KuraZuzu/fast_respect/fast_respect_ピンアサイン.png

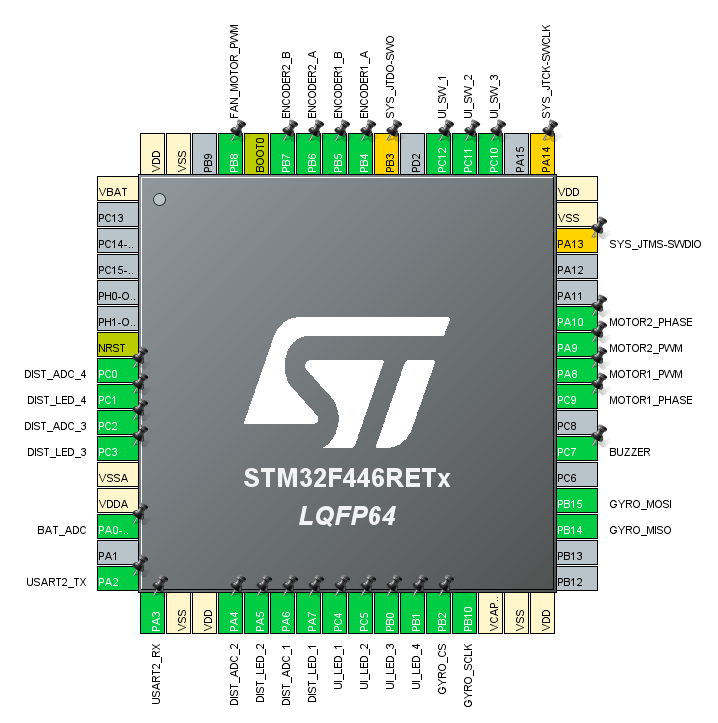
fast_respect_ピンアサイン.png
