KuraZuzu/fast_respect/fast_respect_ピンアサイン_取り付け角度画像.png

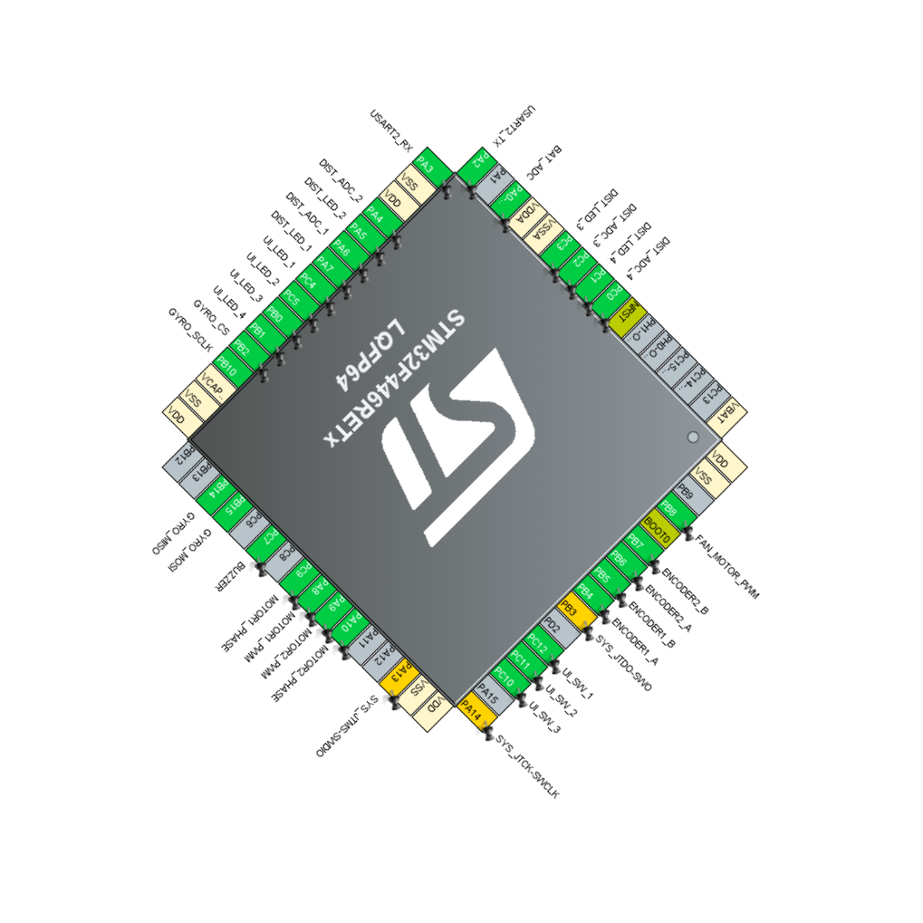
fast_respect_ピンアサイン_取り付け角度画像.png
