KuraZuzu/fast_respect/fast_respect_chassis_R12DXF.dxf

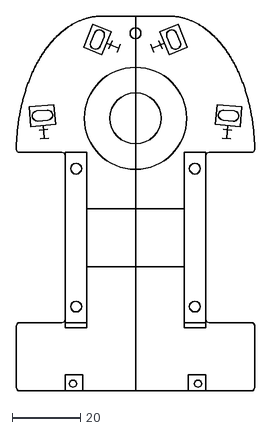
[picture p3: CAD file, 2023-11-23]
fast_respect_chassis_R12DXF.dxf
70.0 x 110.0
