KuraZuzu/fast_respect/fast_respect.kicad_pcb

## KiCad design fast_respect.kicad_pcb (2023-12-19)

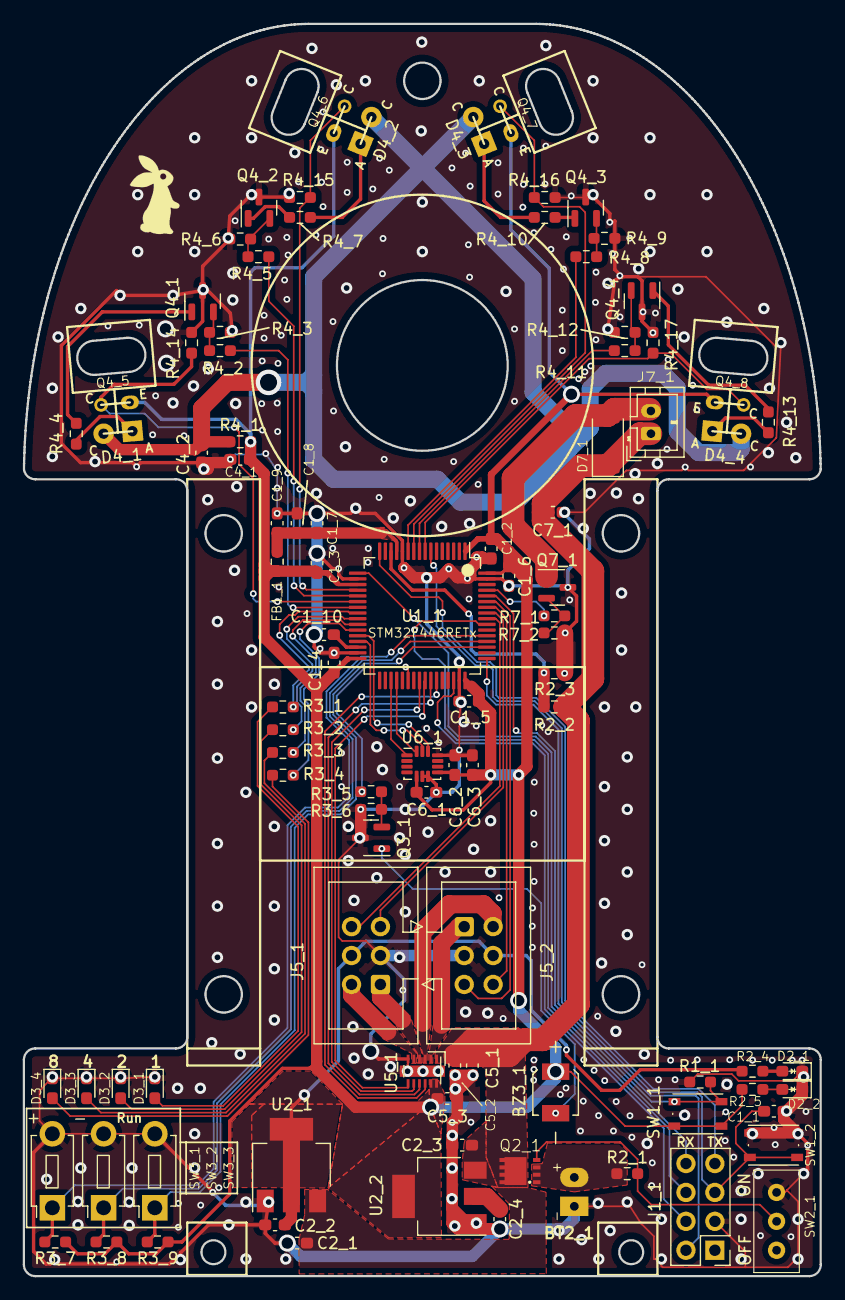
[picture p11: board fast_respect.kicad_pcb from above]

Board: 2 copper layers, 70.0 x 110.0 mm, 97 parts (0 on the bottom side), 72 nets.

Parts:
BT2_1: Battery; 2sBattery
BZ3_1: SMT-0440-T-HT-R; XDCR_SMT-0440-T-HT-R
C1_1, C1_3, C1_4, C1_5, C1_6, C1_8, C5_2, C5_3, C6_2: 0.1uF; C_0603_1608Metric_Pad1.08x0.95mm_HandSolder
C1_2, C1_10: 4.7uF; C_0603_1608Metric_Pad1.08x0.95mm_HandSolder
C1_7, C6_1: 0.01uF; C_0603_1608Metric_Pad1.08x0.95mm_HandSolder
C1_9, C4_1, C4_2: 1uF; C_0603_1608Metric_Pad1.08x0.95mm_HandSolder
C2_1, C2_3, C5_1, C7_1: 10uF; C_0603_1608Metric_Pad1.08x0.95mm_HandSolder
C2_2, C2_4: 22uF; C_0603_1608Metric_Pad1.08x0.95mm_HandSolder
C6_3: 2.2uF; C_0603_1608Metric_Pad1.08x0.95mm_HandSolder
D2_1: LED_R; LED_0603_1608Metric_Pad1.05x0.95mm_HandSolder
D2_2: LED_Y; LED_0603_1608Metric_Pad1.05x0.95mm_HandSolder
D3_1: LED_B1; LED_0603_1608Metric_Pad1.05x0.95mm_HandSolder
D3_2: LED_B2; LED_0603_1608Metric_Pad1.05x0.95mm_HandSolder
D3_3: LED_B3; LED_0603_1608Metric_Pad1.05x0.95mm_HandSolder
D3_4: LED_B4; LED_0603_1608Metric_Pad1.05x0.95mm_HandSolder
D4_1, D4_2, D4_3, D4_4: SFH4550; DIstance-Sensor_LED_D5.0mm
D7_1: RB080LAM-30TR; D_SOD-128
FB1_1: FerriteBead; R_0603_1608Metric
J1_1: Conn_02x04_Odd_Even; PinHeader_2x04_P2.54mm_Vertical
J5_1, J5_2: Conn_02x03_Odd_Even; IDC-Header_2x03_P2.54mm_Vertical
J7_1: Conn_01x02; JST_PH_B2B-PH-K_1x02_P2.00mm_Vertical
Q2_1: AONM7421; AON7421
Q3_1, Q4_1, Q4_2, Q4_3, Q4_4, Q7_1: IRLML6344T; SOT-23
Q4_5, Q4_6, Q4_7, Q4_8: ST-1KL3A; DIstance-Sensor_PHTR_D5.0mm
R1_1, R3_6, R4_3, R4_6, R4_9, R4_12, R7_2: 10k; R_0603_1608Metric_Pad0.98x0.95mm_HandSolder
R2_1: 100k; R_0603_1608Metric_Pad0.98x0.95mm_HandSolder
R2_2: 2k; R_0603_1608Metric_Pad0.98x0.95mm_HandSolder
R2_3, R3_7, R3_8, R3_9, R4_14, R4_15, R4_16, R4_17: 1k; R_0603_1608Metric_Pad0.98x0.95mm_HandSolder
R2_4: 620; R_0603_1608Metric_Pad0.98x0.95mm_HandSolder
R2_5: 280; R_0603_1608Metric_Pad0.98x0.95mm_HandSolder
R3_1, R3_2, R3_3, R3_4: 100; R_0603_1608Metric_Pad0.98x0.95mm_HandSolder
R3_5, R4_2, R4_5, R4_8, R4_11, R7_1: 10; R_0603_1608Metric_Pad0.98x0.95mm_HandSolder
R4_1: 20; R_0603_1608Metric_Pad0.98x0.95mm_HandSolder
R4_4, R4_7, R4_10, R4_13: 1; R_0603_1608Metric_Pad0.98x0.95mm_HandSolder
SW1_1: BOOT0_SW; SW_Push_1P1T_NO_Vertical_Wuerth_434133025816
SW1_2: NRST_SW; SW_Push_1P1T_NO_Vertical_Wuerth_434133025816
SW2_1: SW_SPDT; SW_Slide_SS12D01G4_AKIZUKI
SW3_1, SW3_2, SW3_3: SW_Push; SW_PUSH_1P1T_6x3.5mm_H4.3_APEM_MJTP1243
U1_1: STM32F446RETx; LQFP-64_10x10mm_P0.5mm
U2_1: AZ1117-5.0; SOT-223-3_TabPin2
U2_2: AZ1117-3.3; SOT-223-3_TabPin2
U5_1: DRV8835DSSR; DRV8835_ThermalExpanded_WSON-12-1EP
U6_1: ICM-42688-P; LGA-14_ExpandPad_3x2.5mm_P0.5mm_LayoutBorder3x4y

Connections:
+3.3V: BZ3_1.LOAD+, C1_2.2, C1_3.2, C1_4.2, C1_5.2, C1_6.2, C2_4.1, C4_1.1, C5_3.2, C6_1.1, C6_2.1, C6_3.1, FB1_1.2, Q4_5.1 (C), Q4_6.1 (C), Q4_7.1 (C), Q4_8.1 (C), R2_5.1, R3_7.1, R3_8.1, R3_9.1, R4_1.2, SW1_1.1, U1_1.1 (VBAT), U1_1.19 (VDD), U1_1.32 (VDD), U1_1.48 (VDD), U1_1.64 (VDD), U2_2.2 (VO), U5_1.11 (Mode), U5_1.12 (VCC), U6_1.5 (VDDIO), U6_1.8 (VDD)
+5V: C2_2.1, J5_1.4, J5_2.4, R2_4.1, U2_1.2 (VO)
+8V: C2_1.1, C2_3.1, C5_1.2, C5_2.1, C7_1.1, D7_1.1 (K), J7_1.1, Q2_1.3 (D), R2_2.1, U2_1.3 (VI), U2_2.3 (VI), U5_1.1 (VM)
BAT_ADC: R2_2.2, R2_3.1, U1_1.14 (PA0)
BOOT0: R1_1.1, SW1_1.2, U1_1.60 (BOOT0)
BUZZER_PWM: R3_5.1, U1_1.38 (PC7)
DIST_ADC_1: Q4_5.2 (E), R4_14.1, U1_1.22 (PA6)
DIST_ADC_2: Q4_6.2 (E), R4_15.1, U1_1.20 (PA4)
DIST_ADC_3: Q4_7.2 (E), R4_16.1, U1_1.10 (PC2)
DIST_ADC_4: Q4_8.2 (E), R4_17.1, U1_1.8 (PC0)
DIST_LED_1: R4_2.1, U1_1.23 (PA7)
DIST_LED_2: R4_5.1, U1_1.21 (PA5)
DIST_LED_3: R4_8.1, U1_1.11 (PC3)
DIST_LED_4: R4_11.1, U1_1.9 (PC1)
ENCODER1_A: J5_1.6, U1_1.56 (PB4)
ENCODER1_B: J5_1.5, U1_1.57 (PB5)
ENCODER2_A: J5_2.6, U1_1.58 (PB6)
ENCODER2_B: J5_2.5, U1_1.59 (PB7)
FAN_MOTOR_PWM: R7_1.1, U1_1.61 (PB8)
GND: BT2_1.2 (-), C1_1.2, C1_2.1, C1_3.1, C1_4.1, C1_5.1, C1_6.1, C1_7.1, C1_8.1, C1_9.1, C1_10.2, C2_1.2, C2_2.2, C2_3.2, C2_4.2, C4_1.2, C4_2.2, C5_1.1, C5_2.2, C5_3.1, C6_1.2, C6_2.2, C6_3.2, C7_1.2, D2_1.1 (K), D2_2.1 (K), D3_1.1 (K), D3_2.1 (K), D3_3.1 (K), D3_4.1 (K), J1_1.3, J5_1.3, J5_2.3, Q3_1.3 (S), Q4_1.3 (S), Q4_2.3 (S), Q4_3.3 (S), Q4_4.3 (S), Q7_1.3 (S), R1_1.2, R2_3.2, R3_6.2, R4_3.2, R4_6.2, R4_9.2, R4_12.2, R4_14.2, R4_15.2, R4_16.2, R4_17.2, R7_2.2, SW1_2.2, SW2_1.1 (A), SW3_1.2, SW3_2.2, SW3_3.2, U1_1.12 (VSSA), U1_1.18 (VSS), U1_1.31 (VSS), U1_1.47 (VSS), U1_1.63 (VSS), U2_1.1 (GND), U2_2.1 (GND), U5_1.6 (GND), U6_1.6 (GND), U6_1.7 (RESV), U6_1.11 (RESV)
GYRO_CS: U1_1.28 (PB2), U6_1.12 (AP_CS)
GYRO_MISO: U1_1.35 (PB14), U6_1.1 (AP_SDO/AP_AD0)
GYRO_MOSI: U1_1.36 (PB15), U6_1.14 (AP_SDA/AP_SDIO/AP_SDI)
GYRO_SCLK: U1_1.29 (PB10), U6_1.13 (AP_SCL/AP_SCLK)
MOTOR1_OUT_1: J5_1.1, U5_1.4 (BOUT1)
MOTOR1_OUT_2: J5_1.2, U5_1.5 (BOUT2)
MOTOR1_PHASE: U1_1.40 (PC9), U5_1.8 (BIN1/B_PHASE)
MOTOR1_PWM: U1_1.41 (PA8), U5_1.7 (BIN2/B_ENABLE)
MOTOR2_OUT_1: J5_2.1, U5_1.2 (AOUT1)
MOTOR2_OUT_2: J5_2.2, U5_1.3 (AOUT2)
MOTOR2_PHASE: U1_1.43 (PA10), U5_1.10 (AIN1/A_PHASE)
MOTOR2_PWM: U1_1.42 (PA9), U5_1.9 (AIN2/A_ENABLE)
NRST: C1_1.1, J1_1.5, SW1_2.1, U1_1.7 (NRST)
unnamed: BT2_1.1 (+), Q2_1.2 (S), R2_1.1
unnamed: D2_1.2 (A), R2_4.2
unnamed: D2_2.2 (A), R2_5.2
unnamed: D3_1.2 (A), R3_1.2
unnamed: D3_2.2 (A), R3_2.2
unnamed: D3_3.2 (A), R3_3.2
unnamed: D3_4.2 (A), R3_4.2
unnamed: C4_2.1, D4_1.2 (A), D4_2.2 (A), D4_3.2 (A), D4_4.2 (A), R4_1.1
unnamed: D4_1.1 (K), R4_4.1
unnamed: D4_2.1 (K), R4_7.1
unnamed: D4_3.1 (K), R4_10.1
unnamed: D4_4.1 (K), R4_13.1
unnamed: D7_1.2 (A), J7_1.2, Q7_1.1 (D)
unnamed: Q2_1.1 (G), R2_1.2, SW2_1.2 (B)
unnamed: BZ3_1.LOAD-, Q3_1.1 (D)
unnamed: Q3_1.2 (G), R3_5.2, R3_6.1
unnamed: Q4_1.1 (D), R4_4.2
unnamed: Q4_1.2 (G), R4_2.2, R4_3.1
unnamed: Q4_2.1 (D), R4_7.2
unnamed: Q4_2.2 (G), R4_5.2, R4_6.1
unnamed: Q4_3.1 (D), R4_10.2
unnamed: Q4_3.2 (G), R4_8.2, R4_9.1
unnamed: Q4_4.1 (D), R4_13.2
unnamed: Q4_4.2 (G), R4_11.2, R4_12.1
unnamed: Q7_1.2 (G), R7_1.2, R7_2.1
unnamed: C1_10.1, U1_1.30 (VCAP_1)
unnamed: C1_7.2, C1_8.2, C1_9.2, FB1_1.1, U1_1.13 (VDDA)
RX: J1_1.8, U1_1.17 (PA3)
SWCLK: J1_1.2, U1_1.49 (PA14)
SWDIO: J1_1.4, U1_1.46 (PA13)
SWO: J1_1.6, U1_1.55 (PB3)
TX: J1_1.7, U1_1.16 (PA2)
UI_LED_1: R3_1.1, U1_1.24 (PC4)
UI_LED_2: R3_2.1, U1_1.25 (PC5)
UI_LED_3: R3_3.1, U1_1.26 (PB0)
UI_LED_4: R3_4.1, U1_1.27 (PB1)
UI_SW_1: R3_7.2, SW3_1.1, U1_1.53 (PC12)
UI_SW_2: R3_8.2, SW3_2.1, U1_1.52 (PC11)
UI_SW_3: R3_9.2, SW3_3.1, U1_1.51 (PC10)
