KuraZuzu/fast_respect/(commit log)

2023-08-23 回路図プロトタイプ作成
    [distance_sensor.kicad_sch, fast_respect.kicad_pcb, fast_respect.kicad_sch, gyro_sensor.kicad_sch, motor.kicad_sch, motor_and_encoder.kicad_sch, power.kicad_sch, user_interface.kicad_sch]
2023-08-23 コンデンサの表記を統一
    [distance_sensor.kicad_sch, gyro_sensor.kicad_sch, motor_and_encoder.kicad_sch]
2023-08-23 UIのブザー型番を追記
    [motor_and_encoder.kicad_sch, user_interface.kicad_sch]
2023-08-28 モータドライバの型番追加名称変更
    [motor_and_encoder.kicad_sch]
2023-08-28 VCAP1のコンデンサの値追加
    [fast_respect.kicad_sch]
2023-08-28 距離センサのLED制限抵抗のミスを修正。アノテーションも振り直した。
    [distance_sensor.kicad_sch]
2023-08-28 電源スイッチ用の回路のPchMOSFETの向き修正
    [power.kicad_sch]
2023-08-28 エンコーダに型番表記追加
    [motor_and_encoder.kicad_sch]
2023-08-28 ジャイロセンサのアノテーションがモータドライバと重複していたので修正
    [gyro_sensor.kicad_sch]
2023-08-28 pdfに回路図を生成した
2023-08-29 モータドライバのVMに対して10uFのコンデンサ追加（10uFの値は秋月のモジュールを参考）
    [motor_and_encoder.kicad_sch]
2023-08-29 距離センサに強すぎる電流を抑える制限抵抗追加
    [distance_sensor.kicad_sch]
2023-08-29 距離センサの制限抵抗をsource側からdrain側に変更
    [distance_sensor.kicad_sch]
2023-08-29 分圧の抵抗値が間違っていたので修正
    [motor_and_encoder.kicad_sch, power.kicad_sch]
2023-08-30 アノテーション番号ミスの修正とフットプリント割り当て途中（部品リストも途中生成）
    [distance_sensor.kicad_sch, fast_respect.csv, fast_respect.kicad_sch, gyro_sensor.kicad_sch, motor_and_encoder.kicad_sch, power.kicad_sch, user_interface.kicad_sch]
2023-09-01 フェライトビーズに型番追加し、自作パッケージの構成へこう
    [distance_sensor.kicad_sch, fast_respect.kicad_sch, motor_and_encoder.kicad_sch, power.kicad_sch, user_interface.kicad_sch]
2023-09-01 自作パッケージのフォルダ名変更
2023-09-01 ジャイロとモータドライバのフットプリント作成して登録、シンボルと紐付けた。
    [gyro_sensor.kicad_sch, motor_and_encoder.kicad_sch]
2023-09-04 ブザーSMT-0440のフットプリントとシンボルをインポートして、回路図のシンボルを変更した。
    [motor_and_encoder.kicad_sch, user_interface.kicad_sch]
2023-09-04 スイッチ以外のフットプリント割当完了
    [fast_respect.kicad_sch, motor_and_encoder.kicad_sch, power.kicad_sch, user_interface.kicad_sch]
2023-09-04 秋月電子のスライドスイッチのフットプリントを追加して全てのフットプリント割当も完了
    [fast_respect.kicad_sch, power.kicad_sch, user_interface.kicad_sch]
2023-09-07 部品リストをcsvに出力して購入先等の情報を付加した（付加データはまだ途中）
    [fast_respect.csv]
2023-09-08 部品リストのcsv完成
    [fast_respect.csv]
2023-09-08 部品リストの間違いを修正
    [fast_respect.csv]
2023-10-10 吸引ファンのシートとピン追加
    [fast_respect.kicad_sch, motor_and_encoder.kicad_sch, suction_fan.kicad_sch]
2023-10-10 吸引ファンモータのコネクタを追加
    [suction_fan.kicad_sch]
2023-10-23 吸引モータ周りの回路修正
    [fast_respect.kicad_sch, motor_and_encoder.kicad_sch, suction_fan.kicad_sch]
2023-11-23 吸引ファンのダイオードの規格やフットプリント割当を完了（完成）
    [motor_and_encoder.kicad_sch, suction_fan.kicad_sch]
2023-11-23 ネットリスト出力
2023-11-23 R12形式の基板概形DXFデータをファイルに入れた
    [fast_respect_chassis_R12DXF.dxf]
2023-11-23 基板概形インポートしてシルク印刷線とカット線分けた
    [fast_respect.kicad_pcb]
2023-11-23 センサのフットプリント配置
    [fast_respect.kicad_pcb]
2023-11-23 重要パーツ諸々配置した（スイッチの形状や名前とか変えたほうがいいかも）
    [fast_respect.kicad_pcb]
2023-11-23 色々配置した。これから新たなスイッチのフットプリント作る
    [fast_respect.kicad_pcb]
2023-11-23 押しボタンスイッチのフットプリント割り当てを変更
    [fast_respect.kicad_sch, motor_and_encoder.kicad_sch, user_interface.kicad_sch]
2023-11-23 一部のスイッチの名称変更
    [fast_respect.kicad_sch]
2023-11-23 ネットリスト更新
2023-11-23 ネットリストを基板に反映
    [fast_respect.kicad_pcb]
2023-11-23 抵抗とか以外のコア部品配置（バッテリの端子だけ変えた方が良さそう）
    [fast_respect.kicad_pcb]
2023-11-23 モータ+エンコーダのボックス端子の位置がナットと干渉するので修正
    [fast_respect.kicad_pcb]
2023-11-24 ジャイロセンサを中央に配置
    [fast_respect.kicad_pcb]
2023-11-25 2sBatteryのフットプリント作成
2023-11-25 バッテリ端子のフットプリントを割り当ててネットリストに出力して取り込み
    [power.kicad_sch]
2023-11-25 レギュレータ２つのフットプリント割り当てを2ピンが２つあるものに変更した
    [fast_respect.kicad_pcb, motor_and_encoder.kicad_sch, power.kicad_sch]
2023-11-25 gitignoreにKiCAD編集中のファイルを反映した
    [fast_respect.kicad_pcb]
2023-11-25 グリッド原点のをグローバル座標の原点に戻した
    [fast_respect.kicad_pcb]
2023-11-26 マイコンの向きを整えた
    [fast_respect.kicad_pcb]
2023-11-26 UIスイッチ３種類をマイコンピンに割り当て忘れてたので割り当てた
    [fast_respect.kicad_sch, motor_and_encoder.kicad_sch, user_interface.kicad_sch]
2023-11-26 UIスイッチのピン割り当てをネットリストに反映
    [fast_respect.kicad_pcb]
2023-11-26 DRV8835のシンボルのピン割当ミスを修正してシンボル回路図修正(6->8)
    [motor_and_encoder.kicad_sch]
2023-11-26 DRV8835のピン割当ミスを反映
    [fast_respect.kicad_pcb]
2023-11-26 DRV8835用にフットプリント作ってシンボルと紐付けた（シンボルも少し更新）
    [motor_and_encoder.kicad_sch]
2023-11-26 DRV8835のフットプリントをネットリストに反映させてPCBも更新した
    [fast_respect.kicad_pcb]
2023-11-26 距離センサのPCB位置を考慮してピン割り当てを変更した（1,2,3,4 -> 4,3,2,1）
    [fast_respect.kicad_pcb, fast_respect.kicad_sch]
2023-11-26 マイコンの位置を再調整
    [fast_respect.kicad_pcb]
2023-11-26 マイコンのピンアサイン画像を更新
2023-11-26 回路図のPDFを更新
2023-11-26 取り付け角度の画像作成
2023-11-26 ピンアサイン画像のミス修正
2023-11-26 UIのスイッチやLED、書き込み側や電源スイッチの配置を修正
    [fast_respect.kicad_pcb]
2023-11-27 1、２番台の簡易配置をした
    [fast_respect.kicad_pcb]
2023-11-27 全体に全体に おおまかな部品配置完了
    [fast_respect.kicad_pcb]
2023-11-27 色々再配置
    [fast_respect.kicad_pcb]
2023-11-27 吸引ファンの端子がタイヤのナットや吸引ファンマウンタに干渉しそうなので位置修正
    [fast_respect.kicad_pcb]
2023-11-27 各配置を決定した。あとは細かい移動や回転のみ
    [fast_respect.kicad_pcb]
2023-11-27 全ての詳細な位置の数値を決定
    [fast_respect.kicad_pcb]
2023-11-27 吸引ファンマウンタと吸引ファンケーブルが鑑賞する恐れを考慮して移動
    [fast_respect.kicad_pcb]
2023-11-27 全ての配置と方向を設定した。あとは配線するだけ（ブランチを切って作業）
    [fast_respect.kicad_pcb]
2023-11-27 デザインルールの制約を記述
    [fast_respect.kicad_pcb]
2023-11-28 ネットリストを定義（まだ割り振りしていない）
2023-11-28 モータボックス位置再修正
    [fast_respect.kicad_pcb]
2023-11-28 配線とビアのサイズ郡を定義した
2023-11-28 更に配線幅追加
2023-11-28 ジャイロとモータドライバの信号線を書いた
    [fast_respect.kicad_pcb]
2023-11-28 距離センサの信号線まで引いた
    [fast_respect.kicad_pcb]
2023-11-28 ブザー位置をずらして距離センサのLEDのコンデンサ経由の配線を太くした
    [fast_respect.kicad_pcb]
2023-11-28 3.3Vのラインまで距離センサをつないだ
    [fast_respect.kicad_pcb]
2023-11-29 距離センサをGND含めて結んだ
    [fast_respect.kicad_pcb]
2023-11-29 電源周りを配線勧めた
    [fast_respect.kicad_pcb]
2023-11-29 モータドライバからのモータ出力配線を引いた
    [fast_respect.kicad_pcb]
2023-11-29 電源周りを引いた。モータドライバや抵抗、コンデンサの場所を逐次変更した
    [fast_respect.kicad_pcb]
2023-11-29 色々配線
    [fast_respect.kicad_pcb]
2023-11-29 3.3V駆動の配線を整えた
    [fast_respect.kicad_pcb]
2023-11-29 センサとブザー周りの電源修正
    [fast_respect.kicad_pcb]
2023-11-29 UIスイッチ以外配線
    [fast_respect.kicad_pcb]
2023-11-29 UI_LED以外を引いた
    [fast_respect.kicad_pcb]
2023-11-29 全て配線完了（このコミットではUI_LEDを配線）
    [fast_respect.kicad_pcb]
2023-11-29 DRCエラーを解消（まだ未配線あった）
    [fast_respect.kicad_pcb]
2023-11-29 配線完了（DRCもシルクとか以外完了） [補足]距離センサのLEDとフォトトラの冗長な電源配線はノイズのるかもしれないから消していいかも。
    [fast_respect.kicad_pcb]
2023-11-30 数値表示とかを整えた
    [fast_respect.kicad_pcb]
2023-11-30 一旦距離センサのLEDとフォトトランジスタの電源汚すぎるので削除
    [fast_respect.kicad_pcb]
2023-11-30 配線し直し。主に距離線センサ関連の電源周り。まだやっていないがベタGNDもだいぶやりやすくなったはず
    [fast_respect.kicad_pcb]
2023-11-30 ビアの径を変更始め
    [fast_respect.kicad_pcb]
2023-12-01 印刷面以外は納得の配線した（配線太さやビアも納得してるがモータドライバ出力の0.25区間を短くしたい
    [fast_respect.kicad_pcb]
2023-12-01 更にビアを追加した。基板左下と右側の外周がベタグランド通じてないので不安が残る
    [fast_respect.kicad_pcb]
2023-12-03 ベタグランドのために8Vとか吸引ファン関連の素子の位置変えた
    [fast_respect.kicad_pcb]
2023-12-03 ベタグランドのために電源周り位置変えた
    [fast_respect.kicad_pcb]
2023-12-04 電源周りを変えて更にベタに強くした
    [fast_respect.kicad_pcb]
2023-12-04 UIスイッチ周りを整えてベタ強化
    [fast_respect.kicad_pcb]
2023-12-04 配線を完全に完了した。ベタグランドのビアはこれから打つ
    [fast_respect.kicad_pcb]
2023-12-04 ビア打つところまで完全に完了したと思う
    [fast_respect.kicad_pcb]
2023-12-04 ビア打ち直した。これから浮島とかノイズ原因に鳴る半島を削除したい。
    [fast_respect.kicad_pcb]
2023-12-04 ビアを１つ新たに打った。とりあえずシルクとかのエラーを消したい。
    [fast_respect.kicad_pcb]
2023-12-04 色々と文字とかのプリント関係を直したが、これ以上は無視設定が必要そう（Fabの値とシルクがかぶる）
    [fast_respect.kicad_pcb]
2023-12-04 これ以上の印刷面の整えは無理だと思う
    [fast_respect.kicad_pcb]
2023-12-04 マイコンのピンの印刷情報変更
    [fast_respect.kicad_pcb]
2023-12-04 UI_LEDの印刷面の数値を変えた
    [fast_respect.kicad_pcb]
2023-12-04 8Vラインを少し緩やかにした
    [fast_respect.kicad_pcb]
2023-12-04 ウラ面に機体名のシルク追加
    [fast_respect.kicad_pcb]
2023-12-07 ビアと配線を広域削除。表示を値からリファレンスにした
    [fast_respect.kicad_pcb]
2023-12-07 AON7421のフットプリント追加
    [power.kicad_sch, suction_fan.kicad_sch]
2023-12-07 AON7421のシンボル作成
2023-12-07 シンボルとフットプリントのピン番号と割り振りを修正
2023-12-07 AON7421のシンボルを差し替えた
2023-12-07 AON7421のシンボル差し替え
    [power.kicad_sch]
2023-12-07 UI関連のアノテーション番号修正
    [user_interface.kicad_sch]
2023-12-07 バッテリのフットぷりとに領域追加
2023-12-08 ネットリストを更新してpcbに反映
    [fast_respect.kicad_pcb]
2023-12-08 距離センサのLEDとPHTRのフットプリント更新
2023-12-08 距離センサのフットプリントを修正してpcbまで反映
    [distance_sensor.kicad_sch, fast_respect.kicad_pcb]
2023-12-08 各パーツと、その近くのコンデンサの配置完了
    [fast_respect.kicad_pcb]
2023-12-08 これから部品配置を考えつつ配線開始
    [fast_respect.kicad_pcb]
2023-12-08 シンボルのモータの左右を入れ替え
    [fast_respect.kicad_pcb, motor_and_encoder.kicad_sch]
2023-12-08 モータの出力が入れ替わっていなかったので修正
2023-12-08 モータの左右入れ替えをpcbにも反映
    [motor_and_encoder.kicad_sch]
2023-12-08 一旦作業終了
2023-12-10 ２回めのだいたい部品配置完了
    [fast_respect.kicad_pcb]
2023-12-10 電源スイッチ周りを整えた
    [fast_respect.kicad_pcb]
2023-12-10 モータアウトプットのラインと領域を引いた
    [fast_respect.kicad_pcb]
2023-12-10 エンコーダの信号線を引いた
    [fast_respect.kicad_pcb]
2023-12-10 バッテリ+側のベタ追加
    [fast_respect.kicad_pcb]
2023-12-10 8Vラインの大本とか引いた
    [fast_respect.kicad_pcb]
2023-12-10 8V付近の電源周り修正
    [fast_respect.kicad_pcb]
2023-12-11 モータドライバ信号線配線完了
    [fast_respect.kicad_pcb]
2023-12-11 モーター信号線少し修正
    [fast_respect.kicad_pcb]
2023-12-11 マイコンのVDDA周り配線
    [fast_respect.kicad_pcb]
2023-12-11 取り急ぎ電源周り完了
    [fast_respect.kicad_pcb]
2023-12-11 色々配置中
    [fast_respect.kicad_pcb]
2023-12-11 距離センサの向き修正（それと少しの配線追加）
    [fast_respect.kicad_pcb]
2023-12-11 センサ周りの部品を配置
    [fast_respect.kicad_pcb]
2023-12-12 距離センサ周り引いた
    [fast_respect.kicad_pcb]
2023-12-12 左側の3.3vのラインを車体前方まで引いた
    [fast_respect.kicad_pcb]
2023-12-12 電源周りを整えてUIと書き込み配線以外完成
    [fast_respect.kicad_pcb]
2023-12-12 UI_LED接続
    [fast_respect.kicad_pcb]
2023-12-12 書き込みピン配線
    [fast_respect.kicad_pcb]
2023-12-12 UIスイッチ配線完了
    [fast_respect.kicad_pcb]
2023-12-12 全て配線して電気的なDRCは消した
    [fast_respect.kicad_pcb]
2023-12-12 ベタ塗った（ビアない段階だがきれい）
    [fast_respect.kicad_pcb]
2023-12-12 5Vのサーマルパッドベタの領域増やした
    [fast_respect.kicad_pcb]
2023-12-12 モータで使うGNDのビアを大きくした
    [fast_respect.kicad_pcb]
2023-12-12 これからベタGNDのビアを打つ（ついでに一部の配線角度変更）
    [fast_respect.kicad_pcb]
2023-12-12 とりあえずビア打ち完了
    [fast_respect.kicad_pcb]
2023-12-12 ビア打ち直し
    [fast_respect.kicad_pcb]
2023-12-12 ベタGNDをサーマルリリーフにしてビア追加
    [fast_respect.kicad_pcb]
2023-12-12 ビアの配置と島の削除全て完了（印刷面以外は完成）
    [fast_respect.kicad_pcb]
2023-12-13 設計図上に移動して原点セット
    [fast_respect.kicad_pcb]
2023-12-13 印字整え中
    [fast_respect.kicad_pcb]
2023-12-13 印刷面のサイズ位置とか変更
    [fast_respect.kicad_pcb]
2023-12-13 ベタGNDの修正（3.3vと8vを重ねてベタ追加）
    [fast_respect.kicad_pcb]
2023-12-13 吸引ファンのノイズでリセットピンに影響を及ぼす可能性を考慮してある程度戻しつつベタGNDが引けるように微修正
    [fast_respect.kicad_pcb]
2023-12-13 印刷面整えた
    [fast_respect.kicad_pcb]
2023-12-13 マイコンの一部のコンデンサの領域かぶりを修正（これからレビュー出す）
    [fast_respect.kicad_pcb]
2023-12-14 AON7421のフットプリントに裏面シルクが入っていたのを修正
    [fast_respect.kicad_pcb]
2023-12-14 アールティロゴを追加
    [fast_respect.kicad_pcb]
2023-12-14 マシン名とアールティロゴシルク追加
    [fast_respect.kicad_pcb]
2023-12-14 5VラインとベタGND、ビアの修正
    [fast_respect.kicad_pcb]
2023-12-14 干渉の恐れがある吸引コネクタの位置を変えて配線が浮いている箇所を削除
    [fast_respect.kicad_pcb]
2023-12-14 ビアとベタGND及び禁止領域を整えた
    [fast_respect.kicad_pcb]
2023-12-14 シルクの印刷面を修正した。
    [fast_respect.kicad_pcb]
2023-12-14 表面のRTロゴ位置修正（レビュー３にこれから出す）
    [fast_respect.kicad_pcb]
2023-12-15 シルクの位置最終調整と、小さいリファレンスを削除（ポチポチ手動）
    [fast_respect.kicad_pcb]
2023-12-15 吸引ファンコネクタと抵抗がかぶっていたリファレンス修正
    [fast_respect.kicad_pcb]
2023-12-15 発注形式のデータ出力
    [fast_respect-B_Cu.gbl, fast_respect-B_Silkscreen.gbo, fast_respect-Edge_Cuts.gm1, fast_respect-F_Cu.gtl, fast_respect-F_Fab.gbr, fast_respect-F_Paste.gtp, fast_respect-F_Silkscreen.gto, fast_respect.drl]
2023-12-15 発注データのディレクトリ変更
    [fast_respect-B_Cu.gbl, fast_respect-B_Silkscreen.gbo, fast_respect-Edge_Cuts.gm1, fast_respect-F_Cu.gtl, fast_respect-F_Fab.gbr, fast_respect-F_Paste.gtp, fast_respect-F_Silkscreen.gto, fast_respect.drl]
2023-12-15 発注データを入れるフォルダを度変更してzip形式の発注するやつも作った
    [fast_respect-B_Cu.gbl, fast_respect-B_Silkscreen.gbo, fast_respect-Edge_Cuts.gm1, fast_respect-F_Cu.gtl, fast_respect-F_Fab.gbr, fast_respect-F_Paste.gtp, fast_respect-F_Silkscreen.gto, fast_respect.drl]
2023-12-15 ステンシルを含んでいなかったので再度含んで試した
    [fast_respect-B_Cu.gbr, fast_respect-B_Silkscreen.gbr, fast_respect-Edge_Cuts.gbr, fast_respect-F_Cu.gbr, fast_respect-F_Fab.gbr, fast_respect-F_Mask.gbr, fast_respect-F_Paste.gbr, fast_respect-F_Silkscreen.gbr]
2023-12-19 発注データのミスを修正
    [fast_respect-B_Cu.gbl, fast_respect-B_Mask.gbs, fast_respect-B_Paste.gbp, fast_respect-B_Silkscreen.gbo, fast_respect-Edge_Cuts.gm1, fast_respect-F_Cu.gtl, fast_respect-F_Fab.gbr, fast_respect-F_Mask.gts]
